ColonelGeee/Stretch/Score_Stretch.pdf

00:00 | 02:00 | 04:00 | 05:10
Controller 1 | Controller 2

long
short
press

long
short
press

As soon as the spatialization starts, focus on controller 2 (Bass), try to keep it
consistent

Start, when the sound is
established

When filter opens, change
to controller 2, but keep
controller 1 in mind
