ColonelGeee/Stretch/Controller_FinalStrip.JPG

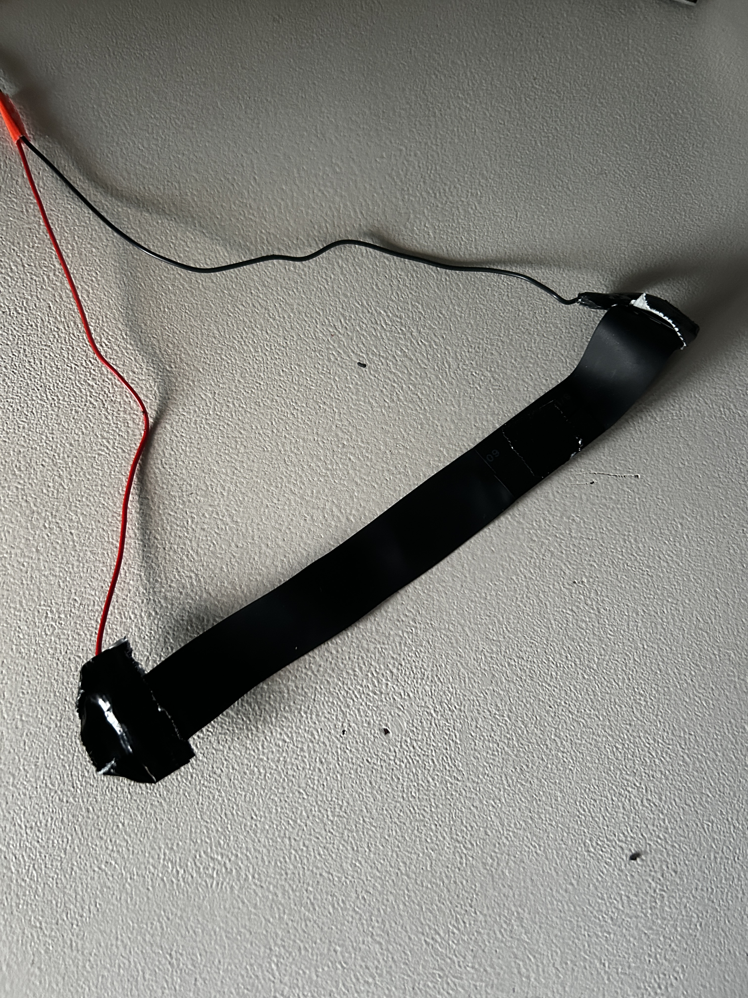
[picture p2: Controller_FinalStrip.JPG]
Controller_FinalStrip.JPG
